Dharun01prasad/Septi-Sense/01_Hardware/breadboard_layout.png

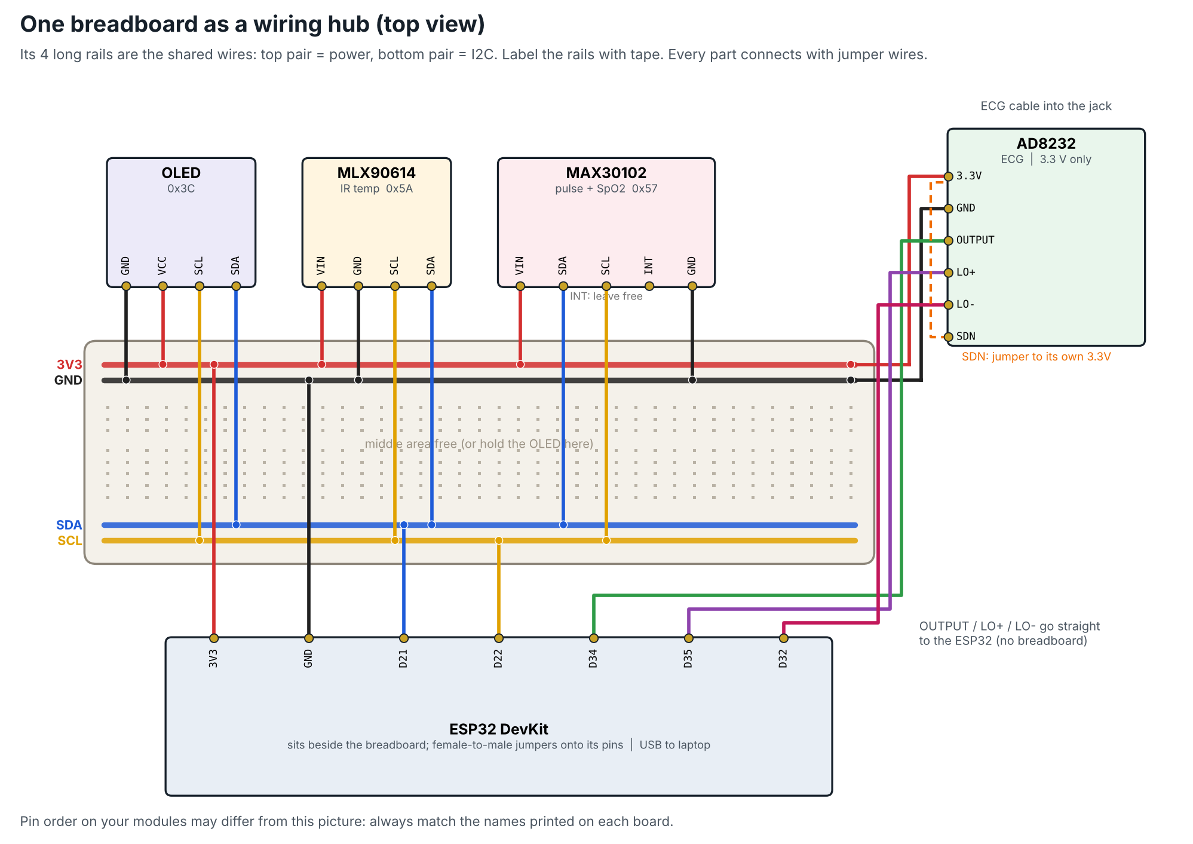
01_Hardware/breadboard_layout.png
