Dharun01prasad/Septi-Sense/01_Hardware/sensor_placement_chest_alternative.png

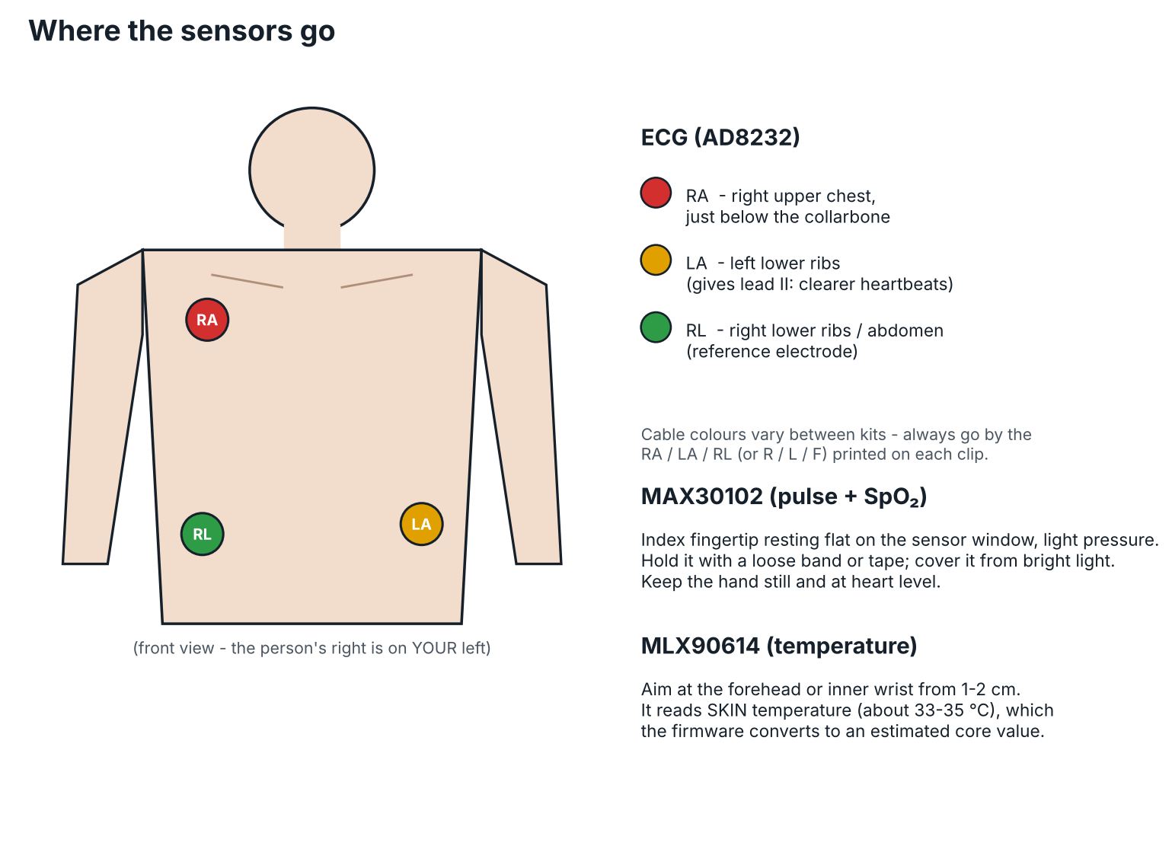
01_Hardware/sensor_placement_chest_alternative.png
