Dharun01prasad/Septi-Sense/01_Hardware/wearable_placement.png

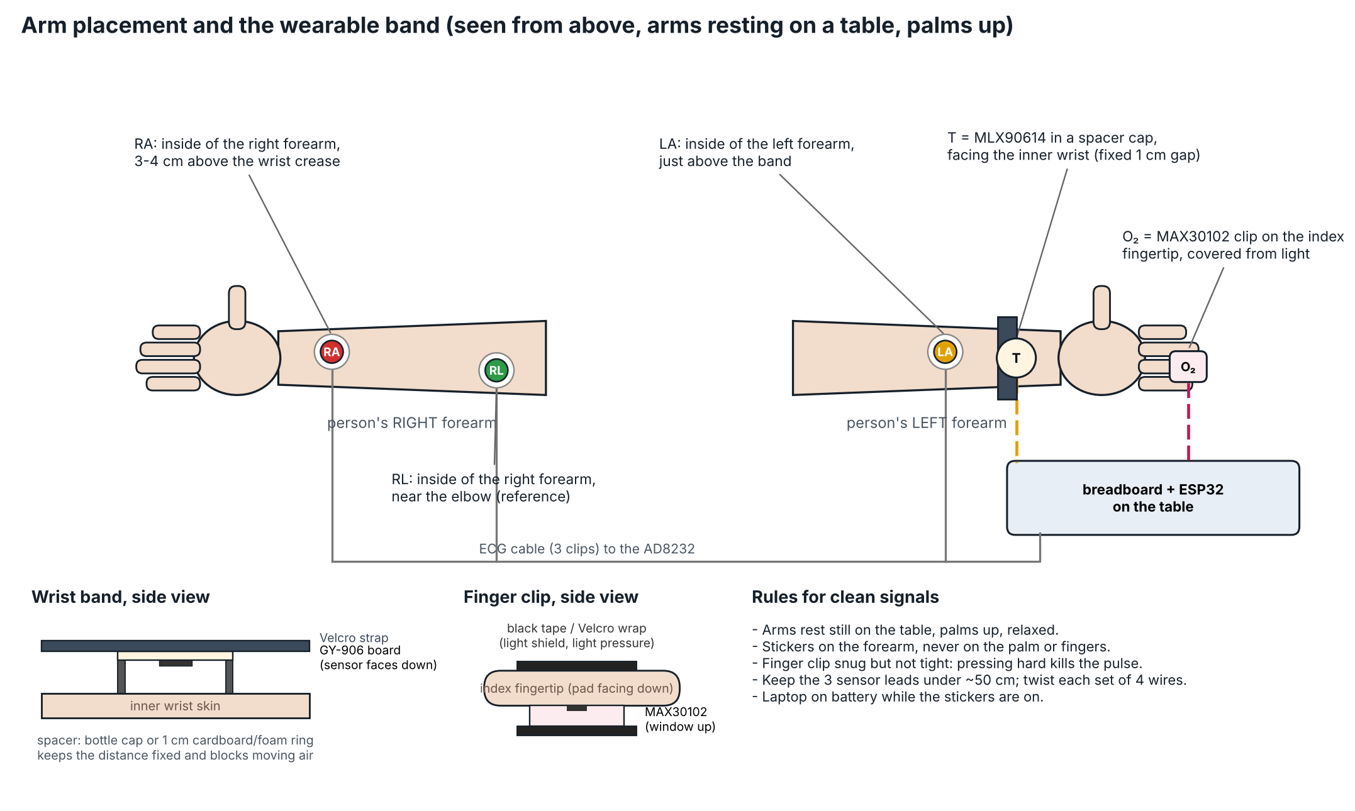
01_Hardware/wearable_placement.png
