Dharun01prasad/Septi-Sense/01_Hardware/wiring_esp32_devkit_v1.png

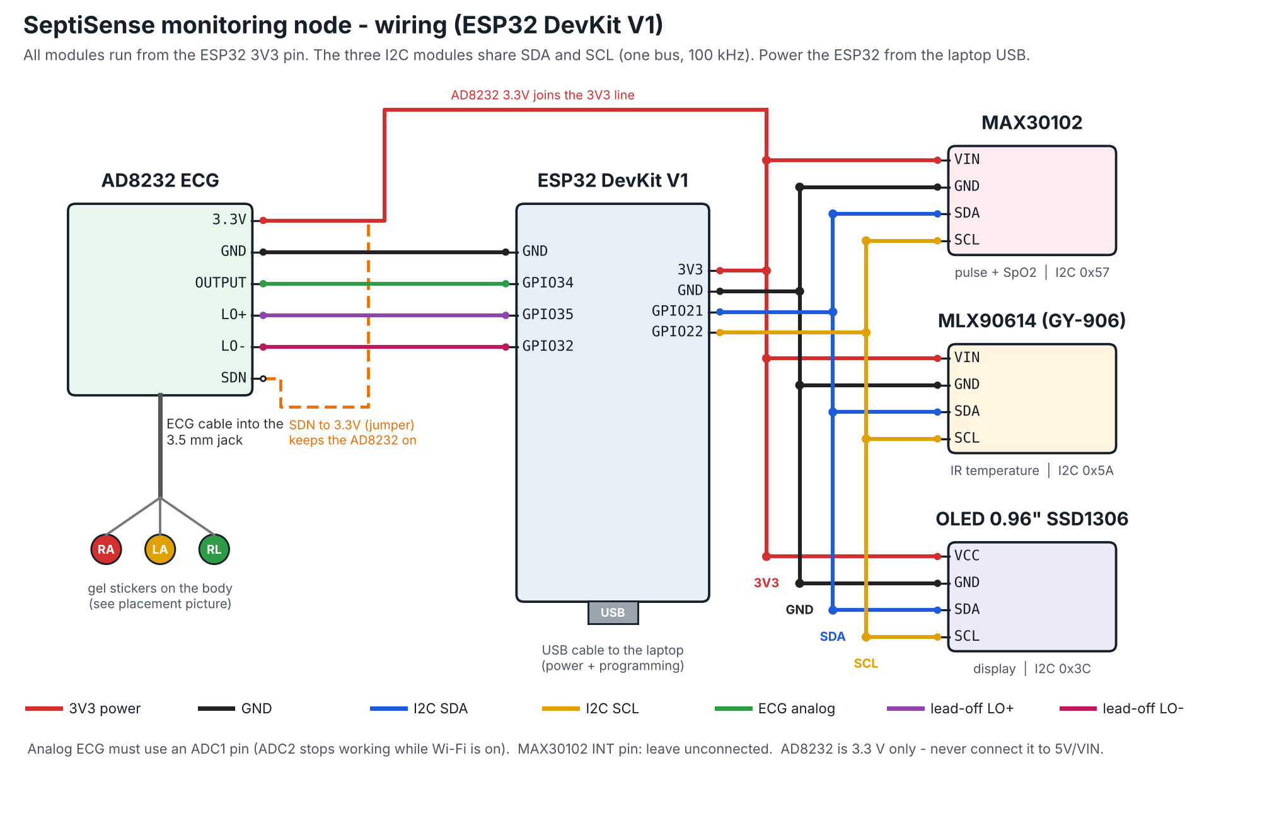
01_Hardware/wiring_esp32_devkit_v1.png
