Dharun01prasad/Septi-Sense/02_ML/results/calibration_alerts_features.png

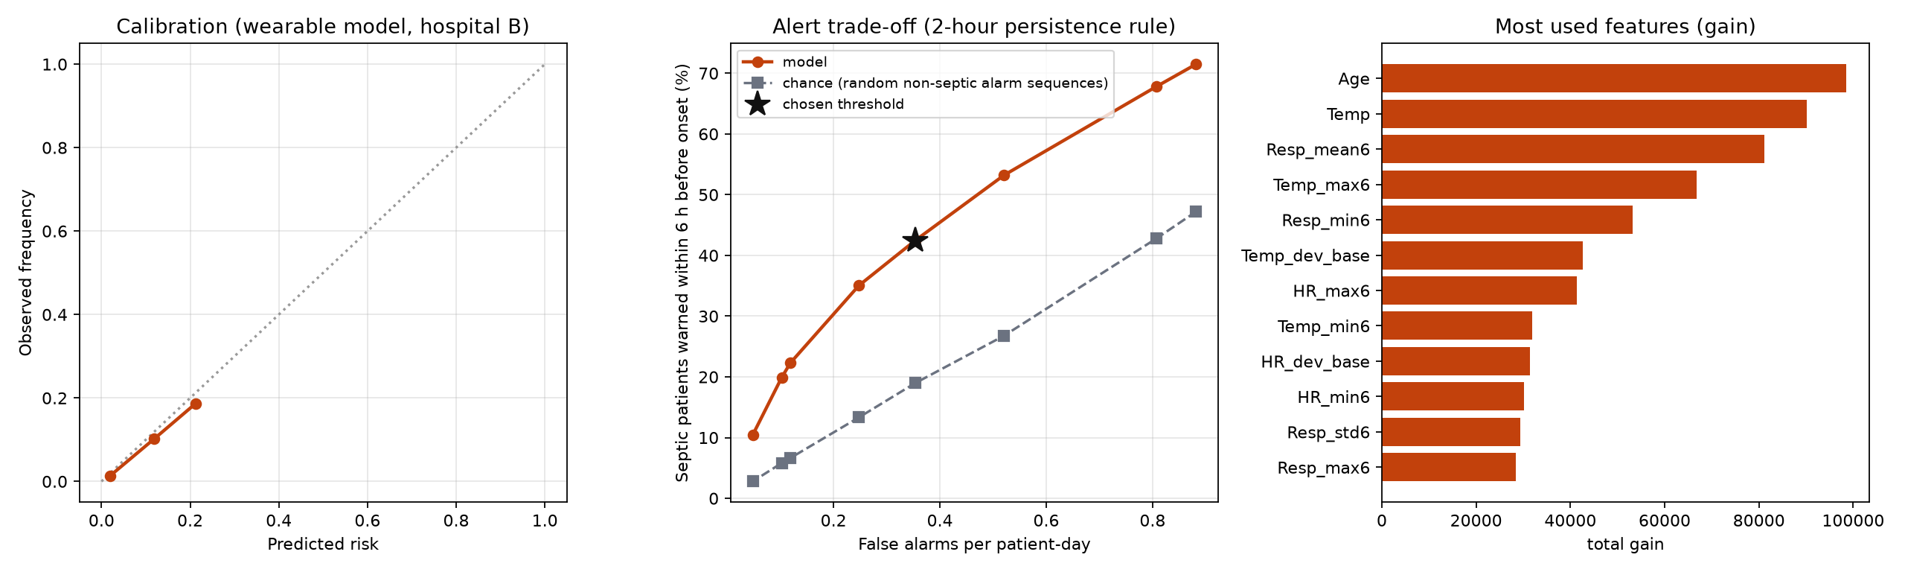
02_ML/results/calibration_alerts_features.png
