Dharun01prasad/Septi-Sense/02_ML/results/roc_pr.png

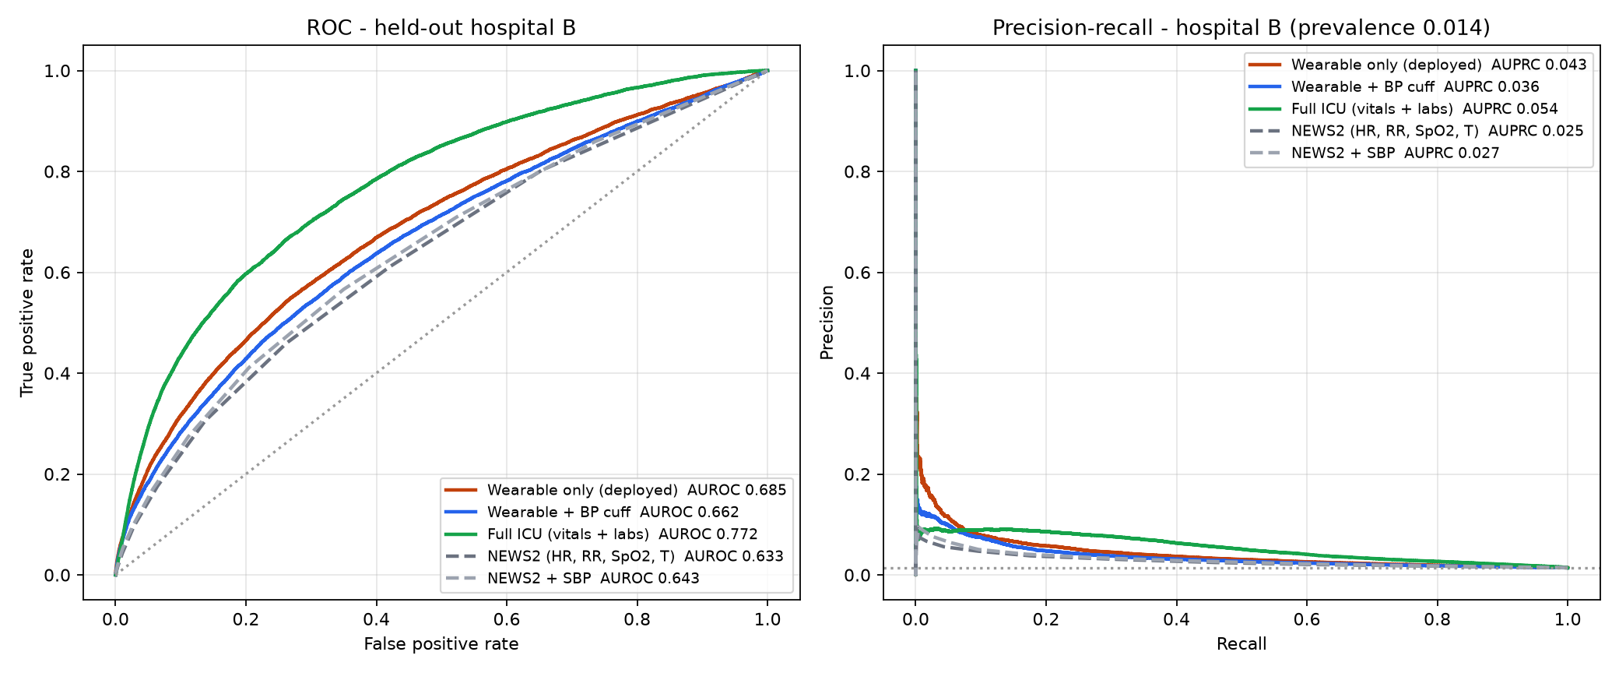
02_ML/results/roc_pr.png
