Dharun01prasad/Septi-Sense/(commit log)

2026-10-30 Working version: 6/12/24 h models, accounts, SMS alerts, patient dashboard
2026-10-31 (Chore) : Final project after reworking
    [Book1.csv, Untitled spreadsheet - Sheet1.csv]
